VidushiGautam/LE2/hotfire_pcbs/HX-board/HX-board.kicad_pcb

## KiCad design hotfire_pcbs/HX-board/HX-board.kicad_pcb (2023-03-24)

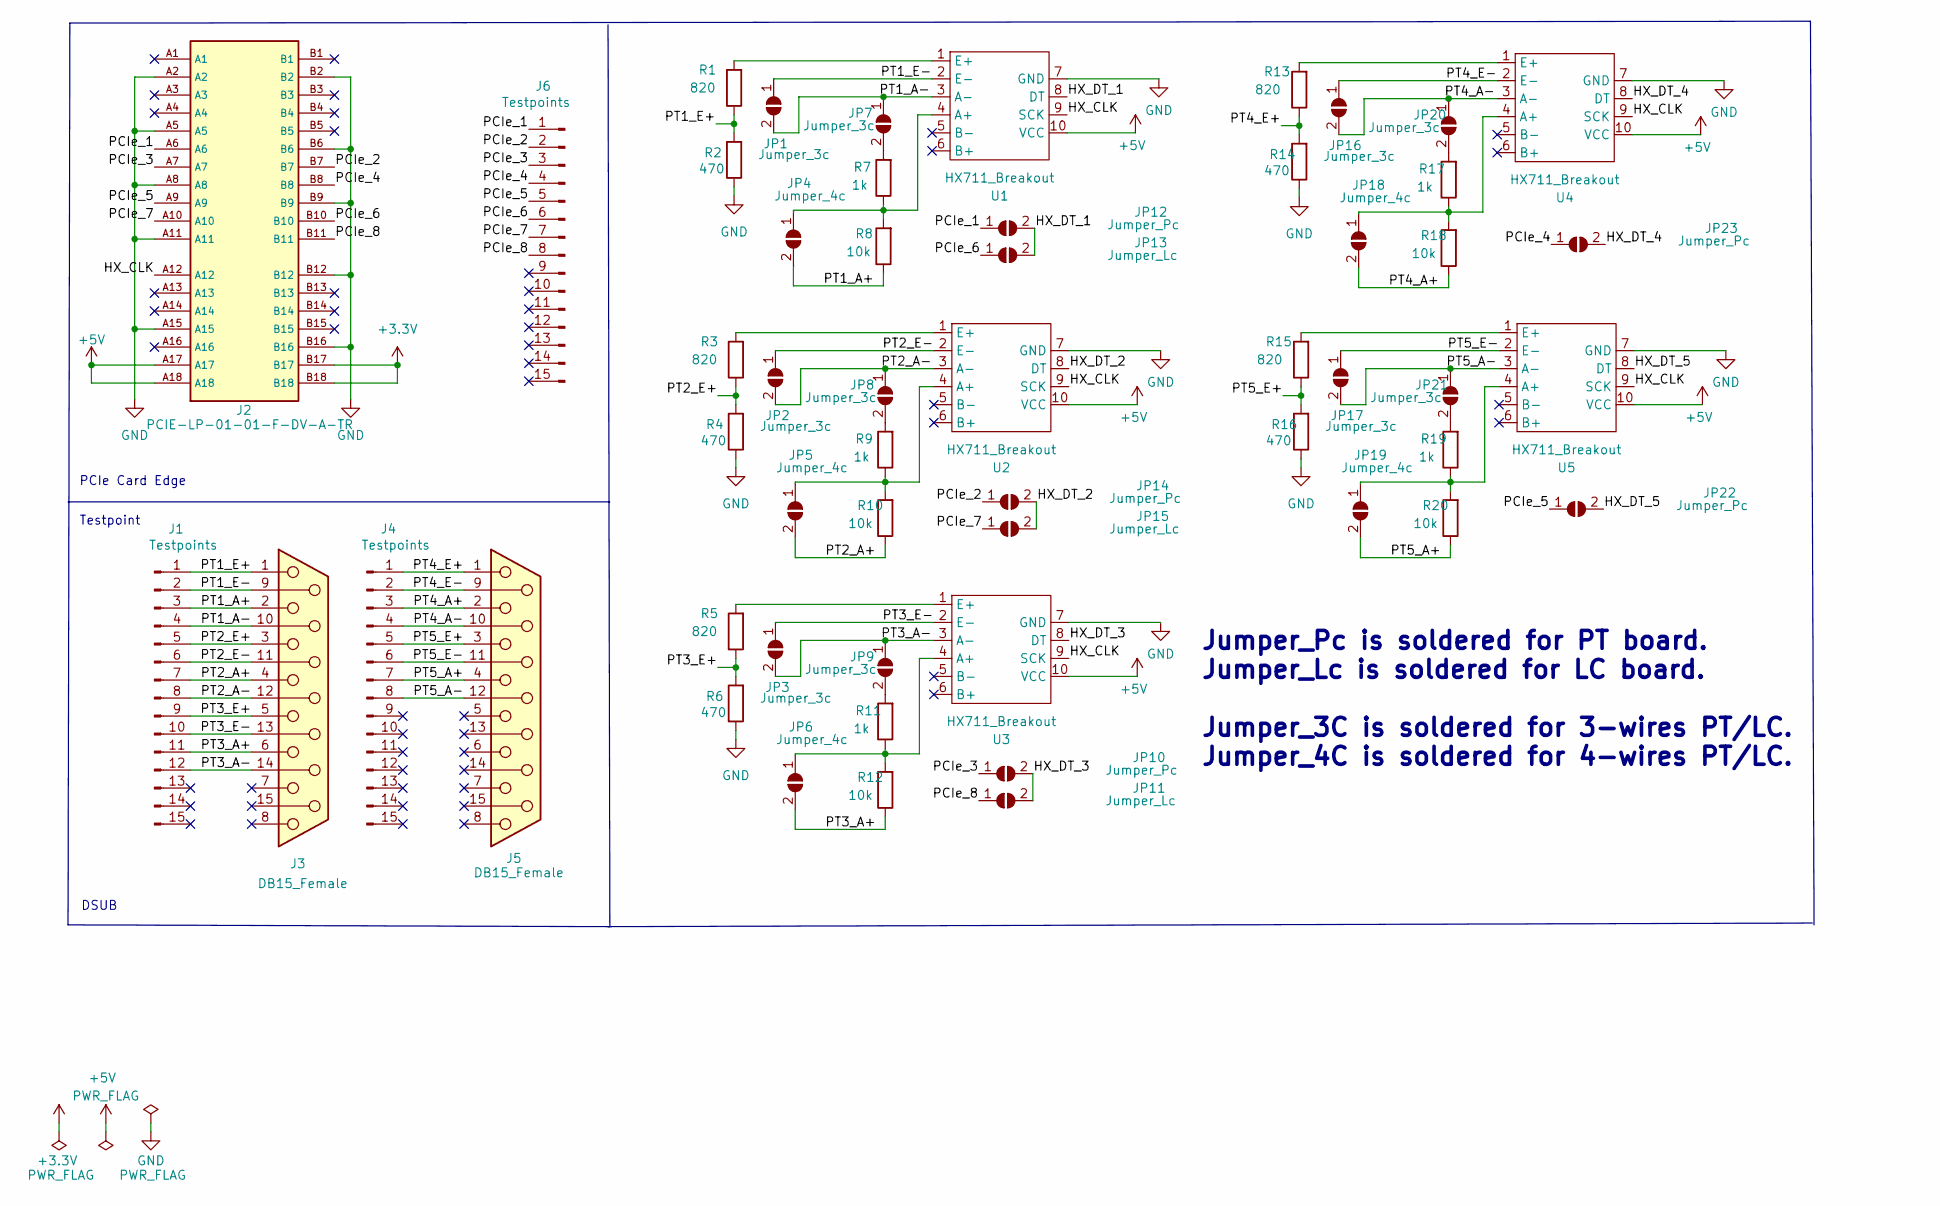
[picture p1: schematic HX-board.kicad_sch]

Parts:
J1, J4, J6: Testpoints; PinHeader_1x15_P2.54mm_Vertical
J2: PCIE-LP-01-01-F-DV-A-TR; BUS_PCIexpress_x1; PARTREV B
J3, J5: DB15_Female; DSUB_622-015-260-042
JP1, JP2, JP3, JP7, JP8, JP9, JP16, JP17, JP20, JP21: Jumper_3c; SolderJumper-2_P1.3mm_Open_RoundedPad1.0x1.5mm
JP4, JP5, JP6, JP18, JP19: Jumper_4c; SolderJumper-2_P1.3mm_Open_RoundedPad1.0x1.5mm
JP10, JP12, JP14, JP22, JP23: Jumper_Pc; SolderJumper-2_P1.3mm_Open_RoundedPad1.0x1.5mm
JP11, JP13, JP15: Jumper_Lc; SolderJumper-2_P1.3mm_Open_RoundedPad1.0x1.5mm
R1, R3, R5, R13, R15: 820; R_0805_2012Metric
R2, R4, R6, R14, R16: 470; R_0805_2012Metric
R7, R9, R11, R17, R19: 1k; R_0805_2012Metric
R8, R10, R12, R18, R20: 10k; R_0805_2012Metric
U1, U2, U3, U4, U5: HX711_Breakout; HX711_Breakout_Board

Connections:
+3.3V: J2.B17, J2.B18
+5V: J2.A17, J2.A18, U1.10 (VCC), U2.10 (VCC), U3.10 (VCC), U4.10 (VCC), U5.10 (VCC)
/HX_CLK: J2.A12, U1.9 (SCK), U2.9 (SCK), U3.9 (SCK), U4.9 (SCK), U5.9 (SCK)
/HX_DT_1: JP12.2 (B), JP13.2 (B), U1.8 (DT)
/HX_DT_2: JP14.2 (B), JP15.2 (B), U2.8 (DT)
/HX_DT_3: JP10.2 (B), JP11.2 (B), U3.8 (DT)
/HX_DT_4: JP23.2 (B), U4.8 (DT)
/HX_DT_5: JP22.2 (B), U5.8 (DT)
/PCIe_1: J2.A6, J6.1, JP12.1 (A)
/PCIe_2: J2.B7, J6.2, JP14.1 (A)
/PCIe_3: J2.A7, J6.3, JP10.1 (A)
/PCIe_4: J2.B8, J6.4, JP23.1 (A)
/PCIe_5: J2.A9, J6.5, JP22.1 (A)
/PCIe_6: J2.B10, J6.6, JP13.1 (A)
/PCIe_7: J2.A10, J6.7, JP15.1 (A)
/PCIe_8: J2.B11, J6.8, JP11.1 (A)
/PT1_A+: J1.3, J3.2, JP4.2 (B), R8.1
/PT1_A-: J1.4, J3.10, JP1.2 (B), JP7.1 (A), U1.3 (A-)
/PT1_E+: J1.1, J3.1, R1.1, R2.2
/PT1_E-: J1.2, J3.9, JP1.1 (A), U1.2 (E-)
/PT2_A+: J1.7, J3.4, JP5.2 (B), R10.1
/PT2_A-: J1.8, J3.12, JP2.2 (B), JP8.1 (A), U2.3 (A-)
/PT2_E+: J1.5, J3.3, R3.1, R4.2
/PT2_E-: J1.6, J3.11 (P111), JP2.1 (A), U2.2 (E-)
/PT3_A+: J1.11, J3.6, JP6.2 (B), R12.1
/PT3_A-: J1.12, J3.14, JP3.2 (B), JP9.1 (A), U3.3 (A-)
/PT3_E+: J1.9, J3.5, R5.1, R6.2
/PT3_E-: J1.10, J3.13, JP3.1 (A), U3.2 (E-)
/PT4_A+: J4.3, J5.2, JP18.2 (B), R18.1
/PT4_A-: J4.4, J5.10, JP16.2 (B), JP20.1 (A), U4.3 (A-)
/PT4_E+: J4.1, J5.1, R13.1, R14.2
/PT4_E-: J4.2, J5.9, JP16.1 (A), U4.2 (E-)
/PT5_A+: J4.7, J5.4, JP19.2 (B), R20.1
/PT5_A-: J4.8, J5.12, JP17.2 (B), JP21.1 (A), U5.3 (A-)
/PT5_E+: J4.5, J5.3, R15.1, R16.2
/PT5_E-: J4.6, J5.11 (P111), JP17.1 (A), U5.2 (E-)
GND: J2.A2, J2.A5, J2.A8, J2.A11, J2.A15, J2.B2, J2.B6, J2.B9, J2.B12, J2.B16, R2.1, R4.1, R6.1, R14.1, R16.1, U1.7 (GND), U2.7 (GND), U3.7 (GND), U4.7 (GND), U5.7 (GND)
unnamed: JP4.1 (A), R7.1, R8.2, U1.4 (A+)
unnamed: JP5.1 (A), R9.1, R10.2, U2.4 (A+)
unnamed: JP6.1 (A), R11.1, R12.2, U3.4 (A+)
unnamed: JP7.2 (B), R7.2
unnamed: JP8.2 (B), R9.2
unnamed: JP9.2 (B), R11.2
unnamed: JP18.1 (A), R17.1, R18.2, U4.4 (A+)
unnamed: JP19.1 (A), R19.1, R20.2, U5.4 (A+)
unnamed: JP20.2 (B), R17.2
unnamed: JP21.2 (B), R19.2
unnamed: R1.2, U1.1 (E+)
unnamed: R3.2, U2.1 (E+)
unnamed: R5.2, U3.1 (E+)
unnamed: R13.2, U4.1 (E+)
unnamed: R15.2, U5.1 (E+)

Notes on the sheet:
DSUB
Testpoint
Jumper_Pc is soldered for PT board. Jumper_Lc is soldered for LC board. Jumper_3C is soldered for 3-wires PT/LC. Jumper_4C is soldered for 4-wires PT/LC.
PCIe Card Edge

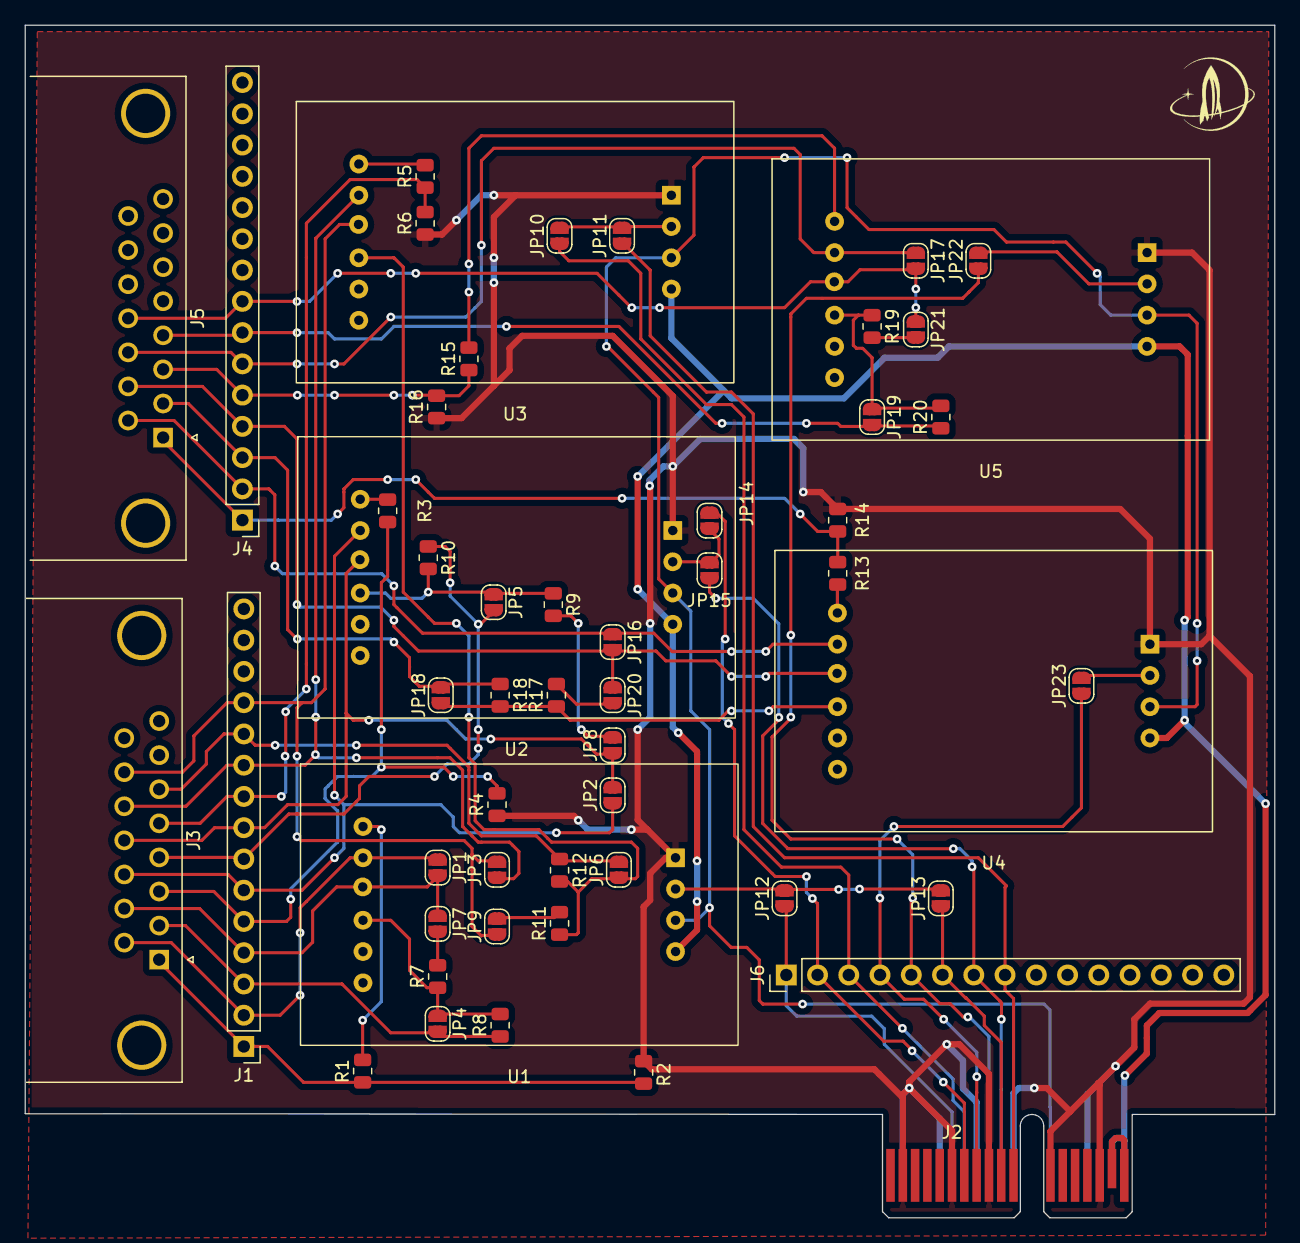
[picture p2: board HX-board.kicad_pcb from above]

Board: 2 copper layers, 101.6 x 96.9 mm, 54 parts (0 on the bottom side), 52 nets.
