VidushiGautam/LE2/hotfire_pcbs/TC-board/TC-board.kicad_pcb

## KiCad design hotfire_pcbs/TC-board/TC-board.kicad_pcb (2023-03-17)

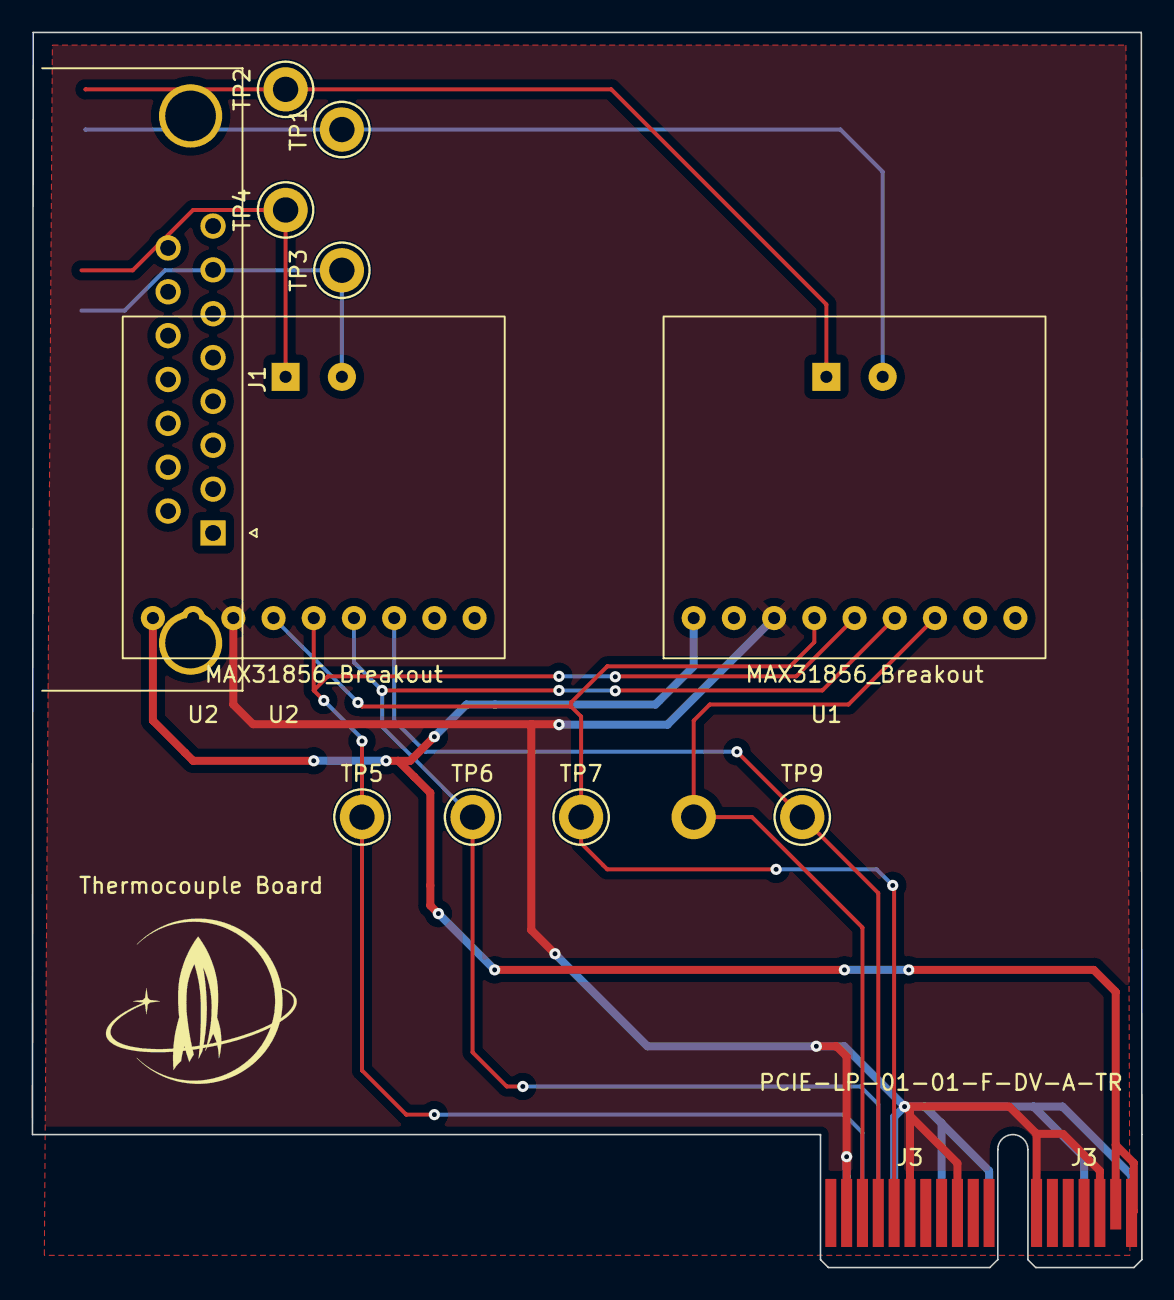
[picture p3: board TC-board.kicad_pcb from above]

Board: 2 copper layers, 70.1 x 78.0 mm, 13 parts (1 on the bottom side), 11 nets.

Parts:
J1: DB15_Female; DSUB_622-015-260-042
J3: PCIE-LP-01-01-F-DV-A-TR; BUS_PCIexpress_x1
TP1, TP2, TP3, TP4, TP5, TP6, TP7, TP8, TP9: TestPoint; TestPoint_Keystone_5010-5014_Multipurpose
U1, U2: MAX31856_Breakout

Connections:
+3.3V: U1.11 (VIN), U2.11 (VIN)
/SPI_CS_0: J3.B3, TP8.1, U1.5 (CS)
/SPI_CS_1: J3.B4, TP9.1, U2.5 (CS)
/SPI_MISO: J3.A3, TP5.1, U1.7 (SDO), U2.7 (SDO)
/SPI_MOSI: J3.A4, TP6.1, U1.6 (SDI), U2.6 (SDI)
/SPI_SCK: J3.B5, TP7.1, U1.8 (SCK), U2.8 (SCK)
/TC1_T+: J1.9, TP2.1, U1.2 (T+)
/TC1_T-: J1.1, TP1.1, U1.1 (T-)
/TC2_T+: J1.10, TP4.1, U2.2 (T+)
/TC2_T-: J1.2, TP3.1, U2.1 (T-)
GND: J3.A2, J3.A5, J3.A8, J3.A11, J3.A15, J3.A18, J3.B2, J3.B6, J3.B9, J3.B12, J3.B16, U1.9 (GND), U2.9 (GND)
