VidushiGautam/LE2/command_acquisition/FALL2023/HOTFIRE_2023-11-18_test1.csv

Start | of | Setup
08:3A:F2:B7:EE:00
352 | -103.94 | -109.22 | -110.82 | -91.88 | -104.68 | 3.00 | 0.00 | 3.00 | 4.00 | 2.00 | 1.00 | 5.00 | 0 | 0 | 1
481 | -104.00 | -109.18 | -110.78 | -91.91 | -104.71 | 1.00 | 5.00 | 7.00 | 4.00 | 6.00 | 8.00 | 9.00 | 0 | 0 | 1
916 | -103.97 | -109.23 | -110.81 | -91.95 | -104.67 | 7.00 | 1.00 | 2.00 | 8.00 | 0.00 | 5.00 | 7.00 | 0 | 0 | 1
932 | -103.95 | -109.23 | -110.82 | -91.93 | -104.68 | 3.00 | 4.00 | 8.00 | 8.00 | 6.00 | 7.00 | 8.00 | 0 | 0 | 1
1180 | -103.93 | -109.20 | -110.80 | -91.88 | -104.72 | 4.00 | 6.00 | 8.00 | 2.00 | 9.00 | 7.00 | 4.00 | 0 | 0 | 1
1449 | -103.94 | -109.23 | -110.84 | -91.90 | -104.66 | 0.00 | 7.00 | 3.00 | 9.00 | 5.00 | 1.00 | 1.00 | 0 | 0 | 1
2335 | -103.96 | -109.18 | -110.80 | -91.93 | -104.71 | 0.00 | 4.00 | 8.00 | 2.00 | 5.00 | 9.00 | 9.00 | 0 | 0 | 1
2336 | -103.93 | -109.25 | -110.81 | -91.91 | -104.71 | 7.00 | 6.00 | 9.00 | 0.00 | 7.00 | 9.00 | 6.00 | 0 | 0 | 1
2347 | -104.00 | -109.18 | -110.78 | -91.94 | -104.66 | 1.00 | 7.00 | 4.00 | 8.00 | 4.00 | 2.00 | 2.00 | 0 | 0 | 1
2925 | -103.98 | -109.22 | -110.83 | -91.93 | -104.71 | 0.00 | 8.00 | 6.00 | 6.00 | 2.00 | 8.00 | 5.00 | 0 | 0 | 1
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
