VidushiGautam/LE2/command_acquisition/FALL2023/HOTFIRE_2023-11-18_test4.csv

drv:0x00,d_drv:0x00,cs0_drv:0x00,hd_drv:0x00,wp_drv:0x00
mode:DIO, | clock | div:1
load:0x3fff0030,len:1344
load:0x40078000,len:13964
load:0x40080400,len:3600
entry | 0x400805f0
Start | of | Setup
08:3A:F2:B7:EE:00
349 | -103.93 | -109.19 | -110.85 | -91.89 | -104.71 | 8.00 | 2.00 | 0.00 | 4.00 | 1.00 | 6.00 | 6.00 | 0 | 0 | 1
1978 | -103.93 | -109.24 | -110.84 | -91.93 | -104.71 | 4.00 | 9.00 | 0.00 | 1.00 | 3.00 | 0.00 | 8.00 | 0 | 0 | 1
2044 | -103.92 | -109.20 | -110.78 | -91.88 | -104.67 | 5.00 | 0.00 | 6.00 | 0.00 | 4.00 | 1.00 | 4.00 | 0 | 0 | 1
2046 | -103.93 | -109.19 | -110.85 | -91.90 | -104.69 | 0.00 | 3.00 | 8.00 | 0.00 | 7.00 | 6.00 | 2.00 | 0 | 0 | 1
2057 | -103.96 | -109.23 | -110.81 | -91.95 | -104.71 | 8.00 | 7.00 | 5.00 | 2.00 | 3.00 | 6.00 | 6.00 | 0 | 0 | 1
2057 | -103.97 | -109.22 | -110.83 | -91.88 | -104.69 | 4.00 | 8.00 | 6.00 | 2.00 | 8.00 | 8.00 | 2.00 | 0 | 0 | 1
2067 | -103.96 | -109.24 | -110.85 | -91.91 | -104.67 | 9.00 | 8.00 | 4.00 | 1.00 | 6.00 | 2.00 | 7.00 | 0 | 0 | 1
2545 | -103.99 | -109.24 | -110.77 | -91.90 | -104.72 | 4.00 | 6.00 | 1.00 | 5.00 | 9.00 | 2.00 | 3.00 | 0 | 0 | 1
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
