VidushiGautam/LE2/Arduino/SPRING23-HOTFIRE/DAQ/DAQBoard_LE2/DAQBoard_LE2.ino

/*
This code runs on the DAQ ESP32 and has a couple of main tasks.
1. Read sensor data
2. Send sensor data to COM ESP32
3. Actuate hotfire sequence
*/

/*
Changes:
Removes duplicate codes from functions.
Merge state and currDAQState to DAQState.
Rename commandedState to COMState.
Rename getData() to fetchCOMState().
Rename CheckDebug() to syncDAQState().
Move duplicated code in loop()'s switch case statement to before the switch.
Remove a lot of CheckDebug() call because commandedState is only updated at 2 locations.
Changed idle to setAllBitsUp() instead of setting each mosfet individually.
Fixed abort_sequence setBitDown() instead of setBitUp() for the second vent lox if statement.
Rename pcf to mosfet_pcf.
Change order of functions to have better grouping and flow.
Add if statement to not call mosfet_pcf if it is not found. (caused slowness if mosfet board is not plugged in).
  Abstract pcf.setLeftBitUp with mosfetCloseValve(mosfet_num).
Prevent mosfet's activation if DEBUG is ON. Dangerous if we move to ignite state by accident.
Renamed the wifi data send functions to have better flow.
Used Struct to decrease variable declarations of HX711 and MAX31855.
Changed while loop to if. Move the stop condition to the loop funtion instead.
Renamed Readings to Packet.

TODO:
Need to ask Liam what should happen in each state and update it in general.
Check threshold in press(). The variable is used in some comparison, but not other.
Remove redundant/repetitive call to pcf.
*/

//::::::Libraries::::::://
#include <Arduino.h>
#include <esp_now.h>
#include <WiFi.h>
#include <Wire.h>
#include <SPI.h>
#include "HX711.h"
#include "Adafruit_MAX31855.h"
#include <EasyPCF8575.h>


//::::::Global Variables::::::://

// DEBUG TRIGGER: SET TO 1 FOR DEBUG MODE.
int DEBUG = 0;     // Simulate LOX and Eth fill.
int WIFIDEBUG = 0; // Don't send data.

// MODEL DEFINED PARAMETERS FOR TEST/HOTFIRE. Pressures in psi //
float pressureFuel  = 412;  // Set pressure for fuel: 412
float pressureOx    = 445;  // Set pressure for lox: 445
float threshold     = 0.97; // re-pressurrization threshold (/1x)
float ventTo        = 10;   // c2se solenoids at this pressure to preserve lifetime.
float LOXventing    = 30;   // pressure at which ethanol begins venting
#define abortPressure 525   // Cutoff pressure to automatically trigger abort
#define period        0.5   // Sets period for bang-bang control
float sendDelay     = 250;  // Sets frequency of data collection. 1/(sendDelay*10^-3) is frequency in Hz
// END OF USER DEFINED PARAMETERS //
// refer to https://docs.google.com/spreadsheets/d/17NrJWC0AR4Gjejme-EYuIJ5uvEJ98FuyQfYVWI3Qlio/edit#gid=1185803967 for all pinouts


//::::::DEFINE INSTRUMENT PINOUTS::::::://

typedef struct struct_hx711 {
  HX711 scale;
  float reading;
  int clk;
  int gpio;
  float offset;
  float slope;
} struct_hx711;

#define HX_CLK 27

// PRESSURE TRANSDUCERS
struct_hx711 PT_O1 {{}, -1, HX_CLK, 36, 1.32, 0.0000412};
struct_hx711 PT_O2 {{}, -1, HX_CLK, 39, 7.25, 0.000102};
struct_hx711 PT_E1 {{}, -1, HX_CLK, 35, -28.97, 0.0051};
// struct_hx711 PT_E2 {{}, -1, HX_CLK, 35, 2954, -1.423}; // Change GPIO PIN
struct_hx711 PT_C1 {{}, -1, HX_CLK, 32, -4.763, 0.0001055};

// LOADCELLS
struct_hx711 LC_1  {{}, -1, HX_CLK, 33, 10.663, 0.0007518};
struct_hx711 LC_2  {{}, -1, HX_CLK, 25, 10.663, 0.0007687};
struct_hx711 LC_3  {{}, -1, HX_CLK, 26, 10.663, 0.0007687};

// THERMOCOUPLES
typedef struct struct_max31855 {
  Adafruit_MAX31855 scale;
  float reading;
  float cs;
  float offset;
  float slope;
} struct_max31855;

#define TC_CLK 1 // fix this.
#define TC_DO  1 // fix this.

struct_max31855 TC_1 {Adafruit_MAX31855(TC_CLK, 16, TC_DO), 16, -1, 0, 0};
struct_max31855 TC_2 {Adafruit_MAX31855(TC_CLK, 4, TC_DO), 4, -1, 0, 0};
struct_max31855 TC_3 {Adafruit_MAX31855(TC_CLK, 4, TC_DO), 4, -1, 0, 0};
struct_max31855 TC_4 {Adafruit_MAX31855(TC_CLK, 4, TC_DO), 4, -1, 0, 0};

// GPIO expander
#define I2C_SDA 21
#define I2C_SCL 22

// MOSFETS
#define MOSFET_IGNITER  11
#define MOSFET_ETH_MAIN  10
#define MOSFET_EXTRA    14
#define MOSFET_LOX_MAIN  3
#define MOSFET_ETH_PRESS 4
#define MOSFET_LOX_PRESS 5
#define MOSFET_VENT_ETH  6
#define MOSFET_VENT_LOX  7
//#define MOSFET_P_VENT_LOX //NEED PIN
//#define MOSFET_P_VENT_ETH //NEED PIN
#define MOSFET_QD_LOX 12
#define MOSFET_QD_ETH 13

// Initialize mosfets' io expander.
EasyPCF8575 mosfet_pcf;
bool mosfet_pcf_found;

//::::::STATE VARIABLES::::::://
enum STATES {IDLE, ARMED, PRESS, QD, IGNITION, HOTFIRE, ABORT};
String state_names[] = {"Idle", "Armed", "Press", "QD", "Ignition", "HOTFIRE", "Abort"};
int COMState;
int DAQState;
bool ethComplete = false;
bool oxComplete = false;
bool pressComplete = false ;
bool oxVentComplete = false;
bool ethVentComplete = false;
int ignStart;

// Delay between loops.
#define IDLE_DELAY 250
#define GEN_DELAY 25


//::::DEFINE READOUT VARIABLES:::://
String serialMessage;
float sendTime;
short int queueLength = 0;

// Define variables to store readings to be sent

// Structure example to send data.
// Must match the receiver structure.
typedef struct struct_message {
  int messageTime;
  float PT_O1;
  float PT_O2;
  float PT_E1;
  float PT_E2;
  float PT_C1;
  float LC_1;
  float LC_2;
  float LC_3;
  float TC_1;
  float TC_2;
  int COMState;
  int DAQState;
  short int queueLength;
  bool pressComplete;
  bool ethComplete;
  bool oxComplete;
  // bool oxvent;
  // bool ethVent;
  // bool VentComplete;
} struct_message;

// Create a struct_message called Packet to be sent.
struct_message Packet;
// Create a queue for Packet in case Packets are dropped.
struct_message PacketQueue[120];

// Create a struct_message to hold incoming commands
struct_message Commands;


//::::::Broadcast Variables::::::://
esp_now_peer_info_t peerInfo;
// REPLACE WITH THE MAC Address of your receiver

// OLD COM BOARD {0xC4, 0xDD, 0x57, 0x9E, 0x91, 0x6C}
// COM BOARD {0x7C, 0x9E, 0xBD, 0xD7, 0x2B, 0xE8}
// HEADERLESS BOARD {0x7C, 0x87, 0xCE, 0xF0 0x69, 0xAC}
// NEWEST COM BOARD IN EVA {0x24, 0x62, 0xAB, 0xD2, 0x85, 0xDC}
// uint8_t broadcastAddress[] = {0x24, 0x62, 0xAB, 0xD2, 0x85, 0xDC};
uint8_t broadcastAddress[] = {0xC8, 0xF0, 0x9E, 0x50, 0x23, 0x34};
// {0x7C, 0x87, 0xCE, 0xF0, 0x69, 0xAC};
// {0x3C, 0x61, 0x05, 0x4A, 0xD5, 0xE0};
// {0xC4, 0xDD, 0x57, 0x9E, 0x96, 0x34};
// Callback when data is sent
// void OnDataSent(const uint8_t *mac_addr, esp_now_send_status_t status) {
//  sendTime = millis();
// }

// Callback when data is received
void OnDataRecv(const uint8_t * mac, const uint8_t *incomingData, int len) {
  memcpy(&Commands, incomingData, sizeof(Commands));
}

// Initialize all sensors and parameters.
void setup() {
  // pinMode(ONBOARD_LED,OUTPUT);
  Serial.begin(115200);

  while (!Serial) delay(1); // wait for Serial on Leonardo/Zero, etc.

  // HX711.
  PT_O1.scale.begin(PT_O1.gpio, PT_O1.clk); PT_O1.scale.set_gain(64);
  // PT_O2.scale.begin(PT_O2.gpio, PT_O2.clk); PT_O2.scale.set_gain(64);
  PT_E1.scale.begin(PT_E1.gpio, PT_E1.clk);       PT_E1.scale.set_gain(64);
  // PT_E2.scale.begin(PT_E2.gpio, PT_E2.clk); PT_E2.scale.set_gain(64);
  PT_C1.scale.begin(PT_C1.gpio, PT_C1.clk); PT_C1.scale.set_gain(64);
  LC_1.scale.begin(LC_1.gpio, LC_1.clk);    LC_1.scale.set_gain(64);
  LC_2.scale.begin(LC_2.gpio, LC_2.clk);    LC_2.scale.set_gain(64);
  LC_3.scale.begin(LC_3.gpio, LC_3.clk);    LC_3.scale.set_gain(64);

  // Thermocouple.
  pinMode(TC_1.cs, INPUT);
  pinMode(TC_2.cs, INPUT);
  pinMode(TC_3.cs, INPUT);
  pinMode(TC_4.cs, INPUT);

  // MOSFET.
  mosfet_pcf.startI2C(I2C_SDA, I2C_SCL, SEARCH); // Only SEARCH, if using normal pins in Arduino
  mosfet_pcf_found = false;
  if (!mosfet_pcf.check(SEARCH)) {
    Serial.println("Device not found. Try to specify the address");
    Serial.println(mosfet_pcf.whichAddr());
    // while (true); // This while (true) stalls the program until an interrupt occurs.
  } else {
    mosfet_pcf_found = true;
  }
  mosfetCloseAllValves(); // make sure everything is off by default (NMOS: Down = Off, Up = On)
  delay(500); // startup time to make sure its good for personal testing

  // Broadcast setup.
  // Set device as a Wi-Fi Station
  WiFi.mode(WIFI_STA);
  //Print MAC Accress on startup for easier connections
  Serial.println(WiFi.macAddress());

  // Init ESP-NOWf
  if (esp_now_init() != ESP_OK) {
    Serial.println("Error initializing ESP-NOW");
    return;
  }

  // Once ESPNow is successfully Init, we will register for Send CB to
  // get the status of Trasnmitted packet
  // esp_now_register_send_cb(OnDataSent);

  // Register peer
  memcpy(peerInfo.peer_addr, broadcastAddress, 6);
  peerInfo.channel = 0;
  peerInfo.encrypt = false;

  // Add peer
  if (esp_now_add_peer(&peerInfo) != ESP_OK){
    Serial.println("Failed to add peer");
    return;
  }
  // Register for a callback function that will be called when data is received
 if (!WIFIDEBUG) {
  esp_now_register_recv_cb(OnDataRecv);}

  sendTime = millis();
  DAQState = IDLE;
}


//::::::STATE MACHINE::::::://

// Main Structure of State Machine.
void loop() {
  fetchCOMState();
  if (DEBUG) {
    Serial.print(state_names[DAQState]);
  }
  if (DEBUG || COMState == ABORT) {
    syncDAQState();
  }

  logData();

  sendDelay = GEN_DELAY;
  switch (DAQState) {
    case (IDLE):
      sendDelay = IDLE_DELAY;
      if (COMState == ARMED) { syncDAQState(); }
      idle();
      break;

    case (ARMED): // NEED TO ADD TO CASE OPTIONS //ALLOWS OTHER CASES TO TRIGGER //INITIATE TANK PRESS LIVE READINGS
      if (COMState == IDLE || COMState == PRESS) { syncDAQState(); }
      armed();
      break;

    case (PRESS):
      if (COMState == QD && oxComplete && ethComplete) {
        syncDAQState();
        int pressStart = millis();
      }
      press();
      break;

    case (QD):
      if (COMState == IGNITION) { syncDAQState(); }
      quick_disconnect();
      break;

    case (IGNITION):
      if (COMState == HOTFIRE) {
        syncDAQState();
        ignStart = millis();
        }
      ignition();
      break;

    case (HOTFIRE):
      hotfire();
      break;

    case (ABORT):
      if (COMState == IDLE && oxVentComplete && ethVentComplete) { syncDAQState(); }
      abort_sequence();
      break;
  }
}

// State Functions.

// Everything should be off.
void reset() {
  oxComplete = false;
  ethComplete = false;
  pressComplete = false;
  oxVentComplete = false;
  ethVentComplete = false;
}

void idle() {
  // mosfetCloseValve(MOSFET_LOX_MAIN);
  // mosfetCloseValve(MOSFET_ETH_MAIN);
  // mosfetCloseValve(MOSFET_IGNITER);
  // mosfetCloseValve(MOSFET_LOX_PRESS);
  // mosfetCloseValve(MOSFET_ETH_PRESS);
  // mosfetCloseValve(MOSFET_VENT_LOX);
  // mosfetCloseValve(MOSFET_VENT_ETH);
  mosfetCloseAllValves();
  reset(); // must set oxComplete and ethComplete to false!
}

// Oxygen and fuel should not flow yet.
// This function is the same as idle?
void armed() {
  // mosfetCloseValve(MOSFET_LOX_PRESS);
  // mosfetCloseValve(MOSFET_ETH_PRESS);
  mosfetCloseAllValves();
}

void press() {
  if (PT_O1.reading < pressureOx*threshold || PT_E1.reading < pressureFuel*threshold) {
    if (!(oxComplete && ethComplete)) {
      if (PT_O1.reading < pressureOx*threshold) { // Should it be pressureOx*threshold?
        mosfetOpenValve(MOSFET_LOX_PRESS);
        if (DEBUG) {
          PT_O1.reading += 0.1;
        }
      } else {
        mosfetCloseValve(MOSFET_LOX_PRESS);
        oxComplete = true;
      }
      if (PT_E1.reading < pressureFuel*threshold) { // Should it be pressureFuel*threshold?
        mosfetOpenValve(MOSFET_ETH_PRESS);
        if (DEBUG) {
          PT_E1.reading += 0.2;
        }
      } else {
        mosfetCloseValve(MOSFET_ETH_PRESS);
        ethComplete = true;
      }
    }
  }
  CheckAbort();
}

void ignition() {
  mosfetOpenValve(MOSFET_IGNITER);
}

void hotfire() {
  mosfetOpenValve(MOSFET_ETH_MAIN);
  if (millis() >= ignStart+3000) {
    mosfetCloseValve(MOSFET_LOX_MAIN);
  } else {
    mosfetOpenValve(MOSFET_LOX_MAIN);
  }
}

// Disconnect harnessings and check state of rocket.
void quick_disconnect() {
  mosfetCloseValve(MOSFET_LOX_PRESS);
  mosfetCloseValve(MOSFET_ETH_PRESS);
  // vent valves/vent the lines themselves
  //mosfetOpenValve(MOSFET_P_VENT_LOX);
  //mosfetOpenValve(MOSFET_P_VENT_ETH);
  // vent the pressure solenoid for 1 full second
  //if millis() >= (pressStart+1000){
   // mosfetCloseValve(MOSFET_P_VENT_LOX);
   // mosfetCloseValve(MOSFET_P_VENT_ETH);
  // then, disconnect the lines from the rocket itself
    //mosfetOpenValve(MOSFET_QD_LOX);
    //mosfetOpenValve(MOSFET_QD_ETH);
  // }

  CheckAbort();
}

void abort_sequence() {
  // mosfetOpenValve(MOSFET_VENT_LOX);
  // mosfetOpenValve(MOSFET_VENT_ETH);
  // Waits for LOX pressure to decrease before venting Eth through pyro
  mosfetCloseValve(MOSFET_LOX_PRESS);
  mosfetCloseValve(MOSFET_ETH_PRESS);

  int currtime = millis();
  oxVentComplete = !(PT_O1.reading > 1.3*ventTo); // 1.3 is magic number.
  ethVentComplete = !(PT_E1.reading > 1.3*ventTo);
  if(!(oxVentComplete && ethVentComplete)){
    if (PT_O1.reading > LOXventing) { // vent only lox down to loxventing pressure
      mosfetOpenValve(MOSFET_VENT_LOX);
      if (DEBUG) {
        PT_O1.reading = PT_O1.reading - 0.25;
      }
    } else {
      if (PT_E1.reading > ventTo) {
        mosfetOpenValve(MOSFET_VENT_ETH); // vent ethanol
        if (DEBUG) {
          PT_E1.reading = PT_E1.reading - 0.2;
        }
      } else {
        mosfetCloseValve(MOSFET_VENT_ETH);
        ethVentComplete = true;
      }

      if (PT_O1.reading > ventTo) {
        mosfetOpenValve(MOSFET_VENT_LOX); // vent lox
        if (DEBUG) {
          PT_O1.reading = PT_O1.reading - 0.1;
        }
      } else { // lox vented to acceptable hold pressure
        mosfetCloseValve(MOSFET_VENT_LOX); // close lox
        oxVentComplete = true;
      }
    }
  }
}

// Helper Functions

// Get commanded state from COM board.
void fetchCOMState() {
  COMState = Commands.COMState;
  if (Serial.available() > 0) {
    COMState = Serial.read() - 48;
    delay(50);
    // Serial.println(COMState);
  }
}

// Sync state of DAQ board with COM board.
void syncDAQState() {
  DAQState = COMState;
}

void CheckAbort() {
  if (COMState == ABORT || PT_O1.reading >= abortPressure || PT_E1.reading >= abortPressure) {
    mosfetCloseValve(MOSFET_ETH_PRESS);
    mosfetCloseValve(MOSFET_LOX_PRESS);
    DAQState = ABORT;
  }
}

void mosfetCloseAllValves(){
  if (mosfet_pcf_found && !DEBUG) {
    mosfet_pcf.setAllBitsDown();
  }
}
void mosfetCloseValve(int num){
  // It takes power to keep valves closed. Hence, bit is set HIGH.
  if (mosfet_pcf_found && !DEBUG) {
    mosfet_pcf.setLeftBitDown(num);
  }
}
void mosfetOpenValve(int num){
  if (mosfet_pcf_found && !DEBUG) {
    mosfet_pcf.setLeftBitUp(num);
  }
}


//::::::DATA LOGGING AND COMMUNICATION::::::://
void logData() {
  getReadings();
  printSensorReadings();
  if (millis()-sendTime > sendDelay) {
    sendTime = millis();
    sendData();
    // saveData();
  }
}

void getReadings(){
  if (!DEBUG) {
    PT_O1.reading = PT_O1.slope * PT_O1.scale.read() + PT_O1.offset;
    // rPT_O2.reading = PT_O2.slope * PT_O2.scale.read() + PT_O2.offset;
    PT_E1.reading = PT_E1.slope * PT_E1.scale.read() + PT_E1.offset;
    // PT_E2.reading = PT_E2.slope * PT_E2.scale.read() + PT_E2.offset;
    PT_C1.reading = PT_C1.slope * PT_C1.scale.read() + PT_C1.offset;
    LC_1.reading  = LC_1.slope  * LC_1.scale.read()  + LC_1.offset;
    LC_2.reading  = LC_2.slope  * LC_2.scale.read()  + LC_2.offset;
    LC_3.reading  = LC_3.slope  * LC_3.scale.read()  + LC_3.offset;
    // TC_1.reading = TC_1.scale.readCelsius();
    // TC_2.reading = TC_2.scale.readCelsius();
  }
}

void printSensorReadings() {
  serialMessage = "";
  serialMessage.concat(millis());
  serialMessage.concat(" ");
  serialMessage.concat(PT_O1.reading);
  serialMessage.concat(" ");
  serialMessage.concat(PT_O2.reading);
  serialMessage.concat(" ");
  serialMessage.concat(PT_E1.reading);
  serialMessage.concat(" ");
  // serialMessage.concat(PT_E2.reading);
  // serialMessage.concat(" ");
  serialMessage.concat(PT_C1.reading);
  serialMessage.concat(" ");
  serialMessage.concat(LC_1.reading);
  serialMessage.concat(" ");
  serialMessage.concat(LC_2.reading);
  serialMessage.concat(" ");
  serialMessage.concat(LC_3.reading);
  serialMessage.concat(" ");
  serialMessage.concat(TC_1.reading);
  serialMessage.concat(" ");
  serialMessage.concat(TC_2.reading);
  serialMessage.concat(" ");
  serialMessage.concat(DAQState);
  //  serialMessage.concat(readingCap1);
  //  serialMessage.concat(" ");
  //  serialMessage.concat(readingCap2);
  serialMessage.concat(" Queue Length: ");
  serialMessage.concat(queueLength);
}

// Send data to COM board.
void sendData() {
  addPacketToQueue();
  sendQueue();
}

void addPacketToQueue() {
  if (queueLength < 40) {
    queueLength += 1;
    PacketQueue[queueLength].messageTime = millis();
    PacketQueue[queueLength].PT_O1       = PT_O1.reading;
    PacketQueue[queueLength].PT_O2       = PT_O2.reading;
    PacketQueue[queueLength].PT_E1       = PT_E1.reading;
    // PacketQueue[queueLength].PT_E2       = PT_E2.reading;
    PacketQueue[queueLength].PT_C1       = PT_C1.reading;
    PacketQueue[queueLength].LC_1        = LC_1.reading;
    PacketQueue[queueLength].LC_2        = LC_2.reading;
    PacketQueue[queueLength].LC_3        = LC_3.reading;
    PacketQueue[queueLength].TC_1        = TC_1.reading;
    PacketQueue[queueLength].TC_2        = TC_2.reading;
    PacketQueue[queueLength].queueLength = queueLength;
    PacketQueue[queueLength].DAQState    = DAQState;
    PacketQueue[queueLength].oxComplete  = oxComplete;
    PacketQueue[queueLength].ethComplete = ethComplete;
  }
}

void sendQueue() {
  if (queueLength < 0) {
    return;
  }
  // Set values to send
  Packet = PacketQueue[queueLength];

  if (!WIFIDEBUG) {
    // Send message via ESP-NOW
    esp_err_t result = esp_now_send(broadcastAddress, (uint8_t *) &Packet, sizeof(Packet));

    if (result == ESP_OK) {
      Serial.println("Sent with success Data Send");
      queueLength -= 1;
    } else {
      Serial.println("Error sending the data");
    }
  }
}
