VidushiGautam/LE2/(commit log)

2023-03-17 TC Board Layout
    [TC-board.kicad_pcb]
2023-03-17 Changed JST to DSUB
    [TC-board.kicad_pcb, TC-board.kicad_sch]
2023-03-19 Revised schematics for HX711 board.
    [HX-board.kicad_pcb, HX-board.kicad_sch]
2023-03-23 Updated HX711 Board
    [HX-board.kicad_pcb]
2023-03-23 Updated HX711
    [HX-board.kicad_pcb]
2023-03-23 Changed solder jumper footprint to round pad.
    [HX-board.kicad_pcb, HX-board.kicad_sch]
2023-08-25 Rearranged functions to have better flow.
2023-09-23 Fix a few compiling bugs. Still need to be tested
    [DAQBoard_LE2.ino]
2023-10-01 updated QD code, defined mosfet pins, added in the pressure venting and release states
2024-01-29 Commented out code from DAQ SENSE and DAQ POWER, also added if statement in DAQ Power for recieiving DAQ Sense data
